debarshiputatunda/elevox/elebox_frontend/src/assets/harness-preview.png

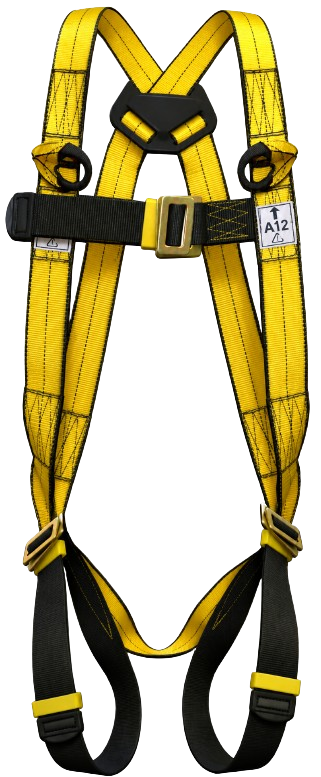
elebox_frontend/src/assets/harness-preview.png
