debarshiputatunda/elevox/Kicad files/Sbox_mkiii_sch_export.kicad_sch

## KiCad design Kicad files/Sbox_mkiii_sch_export.kicad_sch (2026-09-17)

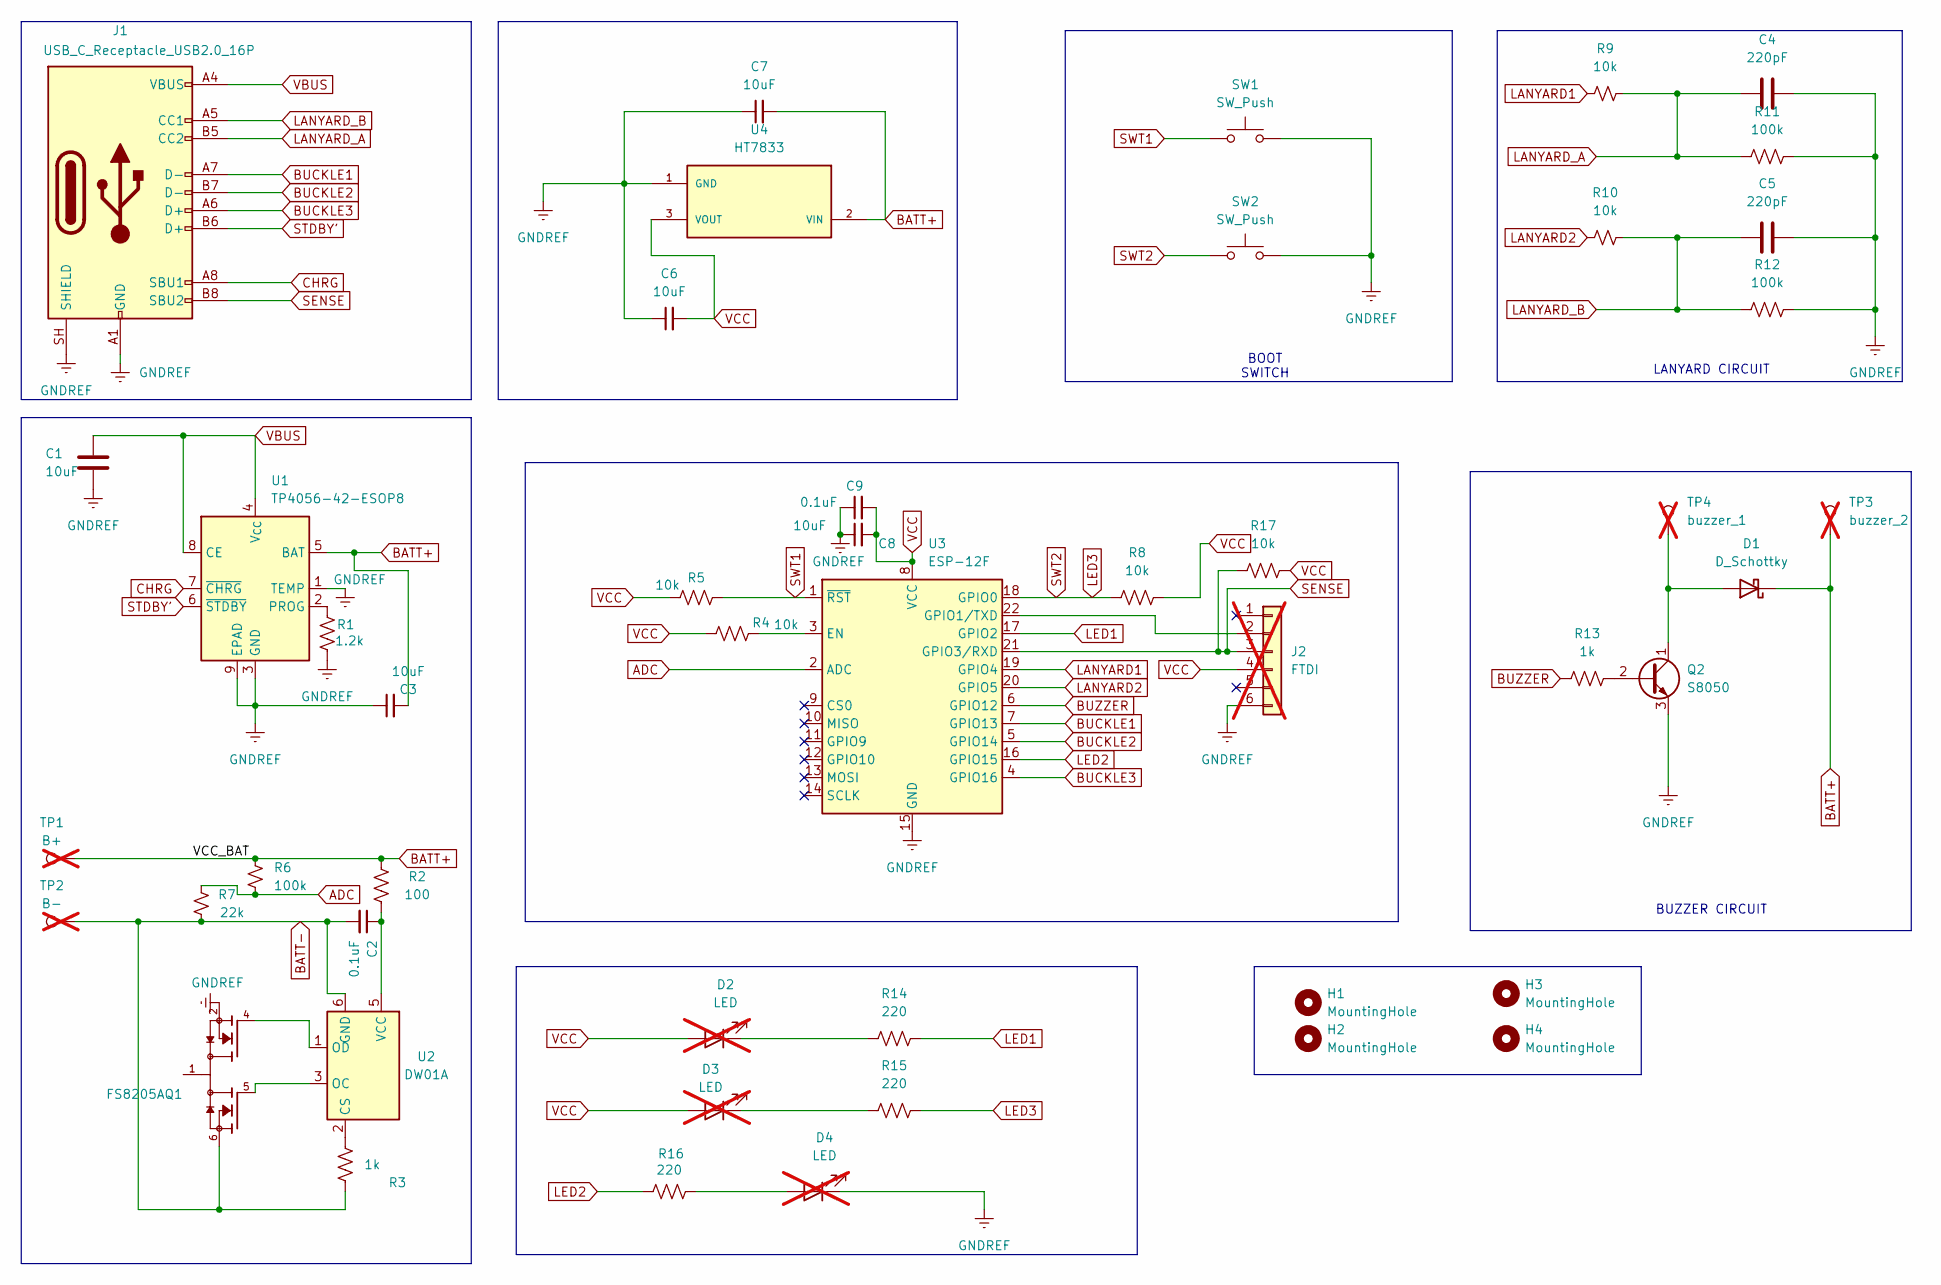
[picture p2: schematic Sbox_mkiii_sch_export.kicad_sch]

Parts:
C1, C3, C6, C7, C8: 10uF; C_0603_1608Metric; LCSC Part # C15499
C2, C9: 0.1uF; C_0805_2012Metric; LCSC Part # C28233
C4, C5: 220pF; C_0805_2012Metric; LCSC Part # C1530
D1: D_Schottky; D_SOD-123; LCSC Part # C191023
D2, D3, D4: LED; LED_D3.0mm; not fitted
H1, H2, H3, H4: MountingHole; MountingHole_4mm
J1: USB_C_Receptacle_USB2.0_16P; USB_C_Receptacle_HRO_TYPE-C-31-M-12; LCSC Part # C165948
J2: FTDI; PinHeader_1x06_P2.54mm_Vertical; not fitted
Q1: FS8205A; SOT-23-6; PARTREV 1.7; LCSC Part # C2830320
Q2: S8050; SOT-23; LCSC Part # C2146
R1: 1.2k; R_0805_2012Metric; LCSC Part # C17379
R2: 100; R_0805_2012Metric; LCSC Part # C17408
R3, R13: 1k; R_0805_2012Metric; LCSC Part # C17513
R4, R5, R8, R9, R10, R17: 10k; R_0805_2012Metric; LCSC Part # C17414
R6, R11, R12: 100k; R_0805_2012Metric; LCSC Part # C149504
R7: 22k; R_0805_2012Metric; LCSC Part # C17560
R14, R15, R16: 220; R_0805_2012Metric; LCSC Part # C17557
SW1, SW2: SW_Push; SW_Push_1P1T_XKB_TS-1187A; LCSC Part # C318884
TP1: B+; TestPoint_Pad_2.5x2.5mm; not fitted
TP2: B-; TestPoint_Pad_2.5x2.5mm; not fitted
TP3: buzzer_2; TestPoint_Pad_2.5x2.5mm; not fitted
TP4: buzzer_1; TestPoint_Pad_2.5x2.5mm; not fitted
U1: TP4056-42-ESOP8; SOIC-8-1EP_3.9x4.9mm_P1.27mm_EP2.41x3.3mm_ThermalVias; LCSC Part # C16581
U2: DW01A; SOT-23-6; LCSC Part # C351410
U3: ESP-12F; ESP-12E; LCSC Part # C19949064
U4: HT7833; SOT-89-3; PARTREV 1.80; LCSC Part # C3011187

Connections:
ADC: R6.2, R7.1, U3.2 (ADC)
BATT+: C3.2, C7.2, D1.1 (K), R2.1, R6.1, TP1.1, TP3.1, U1.5 (BAT), U4.2 (VIN)
BATT-: C2.2, Q1.6, Q1.7, R3.2, R7.2, TP2.1, U2.6 (GND)
BUCKLE1: J1.A7 (D-), U3.7 (GPIO13)
BUCKLE2: J1.B7 (D-), U3.5 (GPIO14)
BUCKLE3: J1.A6 (D+), U3.4 (GPIO16)
BUZZER: R13.1, U3.6 (GPIO12)
CHRG: J1.A8 (SBU1), U1.7 (~CHRG)
GNDREF: C1.2, C3.1, C4.1, C5.2, C6.1, C7.1, C8.1, C9.1, D4.1 (K), J1.A1 (GND), J1.A12 (GND), J1.B1 (GND), J1.B12 (GND), J1.SH (SHIELD), J2.6, Q1.2, Q1.3, Q2.3 (E), R1.2, R11.2, R12.2, SW1.2, SW2.2, U1.1 (TEMP), U1.3 (GND), U1.9 (EPAD), U3.15 (GND), U4.1 (GND)
LANYARD1: R9.1, U3.19 (GPIO4)
LANYARD2: R10.1, U3.20 (GPIO5)
LANYARD_A: C4.2, J1.B5 (CC2), R9.2, R11.1
LANYARD_B: C5.1, J1.A5 (CC1), R10.2, R12.1
LED1: R14.2, U3.17 (GPIO2)
LED2: R16.1, U3.16 (GPIO15)
LED3: R8.1, R15.2, SW2.1, U3.18 (GPIO0)
unnamed: C2.1, R2.2, U2.5 (VCC)
unnamed: D1.2 (A), Q2.1 (C), TP4.1
unnamed: D2.1 (K), R14.1
unnamed: D3.1 (K), R15.1
unnamed: D4.2 (A), R16.2
unnamed: J2.2, U3.22 (GPIO1/TXD)
unnamed: Q1.1, Q1.8
unnamed: Q1.4, U2.1 (OD)
unnamed: Q1.5, U2.3 (OC)
unnamed: Q2.2 (B), R13.2
unnamed: R1.1, U1.2 (PROG)
unnamed: R3.1, U2.2 (CS)
unnamed: R4.2, U3.3 (EN)
SENSE: J1.B8 (SBU2), J2.3, R17.1, U3.21 (GPIO3/RXD)
STDBY': J1.B6 (D+), U1.6 (~STDBY)
SWT1: R5.2, SW1.1, U3.1 (~RST)
VBUS: C1.1, J1.A4 (VBUS), J1.A9 (VBUS), J1.B4 (VBUS), J1.B9 (VBUS), U1.4 (V_{CC}), U1.8 (CE)
VCC: C6.2, C8.2, C9.2, D2.2 (A), D3.2 (A), J2.4, R4.1, R5.1, R8.2, R17.2, U3.8 (VCC), U4.3 (VOUT)

Notes on the sheet:
BUZZER CIRCUIT
BOOT SWITCH
LANYARD CIRCUIT
