debarshiputatunda/elevox/firmware/safety_harness_esp8266_v8/config.h

#pragma once
#if __has_include("config.local.h")
#include "config.local.h"
#endif
#ifndef SBOX_WIFI_SSID
#define SBOX_WIFI_SSID ""
#endif
#ifndef SBOX_WIFI_PASSWORD
#define SBOX_WIFI_PASSWORD ""
#endif
#ifndef SBOX_DEVICE_ID
#define SBOX_DEVICE_ID "SBOX-2026-6265"
#endif
#ifndef SBOX_SCHEMATIC_PINOUT
#define SBOX_SCHEMATIC_PINOUT 0
#endif
