debarshiputatunda/elevox/(commit log)

2026-09-17 Integrate Elevox v5 firmware, monitoring, and macOS launchers
    [Sbox_mkiii_sch_export.kicad_sch, locations_import_template.xlsx, sboxes_import_template.xlsx, users_import_template.xlsx, work_areas_import_template.xlsx]
2026-09-17 Add v6 HIGH-guard hook sensing and passive coupling diagnostics
2026-09-17 Stabilize v6 hotspot and add saved networks and two-way thresholds
    [device_poller.py, network_profiles.h, network_runtime.h, threshold_settings.h, tuning_transaction.h]
2026-09-17 Add v6.2 calibration, stream diagnostics and device preferences
2026-09-18 Fix v7 hotspot interrupt starvation and protect AP connections
    [device_runtime.h, hook_sensing.h, hotspot_policy.h, network_runtime.h, sensing_settings.h]
2026-09-21 Add persistent buckle alarm control to both interfaces
2026-09-23 Build v8 from v7.3.1 and fix default Wi-Fi auto-connect
    [alarm_logic.h, buckle_alarm_runtime.h, buckle_alarm_settings.h, config.h, device_preferences.h, device_runtime.h, hook_case.h]
